Arrygon/Pro_Micro/(commit log)

2013-10-18 Changed jumper package to normally open
    Open Jumper = 3.3V logic
    also added gitignore
    [Pro_Micro.brd, Pro_Micro.sch]
2013-10-18 ignore gerbers and zip files
2013-11-14 repositioned fiducials and one via
    It used to be under the crystal.
    [Pro_Micro.brd]
2013-11-14 add ignore, moved fiductials and one via
    one fid used to be under crystal
    [Pro_Micro.brd]
2015-06-19 Updated to current library parts with correct labels. Changed silk to vector font. Moved a few bits of silk to not be over vias. Aligned angled traces to 45 degrees
    [Pro_Micro.brd, Pro_Micro.sch]
